TeeVau/nfc-garage-position-sensor/docs/assets/github-social-preview.png

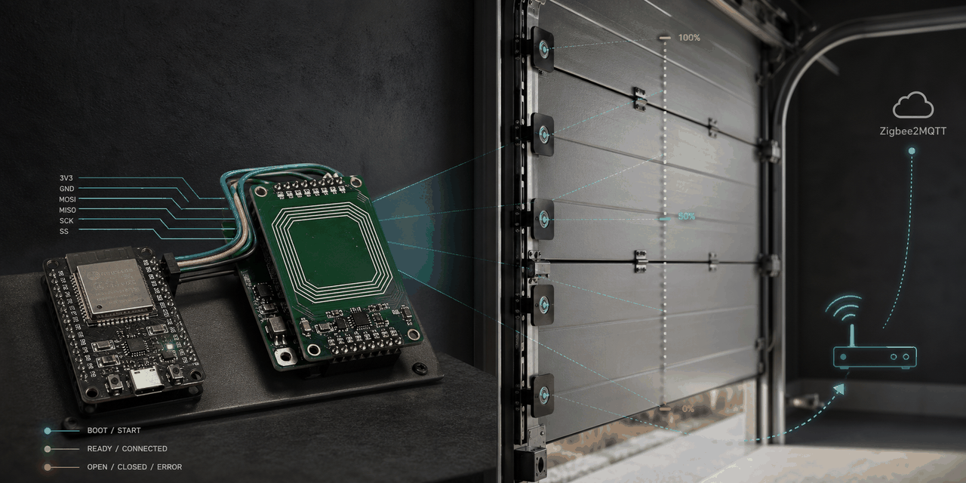
docs/assets/github-social-preview.png
