TeeVau/nfc-garage-position-sensor/docs/z2m-setup.md

# Zigbee2MQTT Setup For The Garage Door Sensor

This document describes the current simplified Zigbee2MQTT setup for the garage door sensor.

Repository layout note:

- firmware sources live under `src/nfc-garage-position-sensor`
- build and flash helpers live under `tools/firmware`

Goal:

- `position`: opening percentage with `0 = closed`, `100 = open`
- `state`: cover state as `CLOSE` / `OPEN`

The firmware currently exposes:

- endpoint `10`: window covering

Metadata relevant for Zigbee2MQTT:

- Basic `modelId`
- Basic `manufacturerName`
- Basic `powerSource`
- Basic `appVersion`
- Basic `swBuildId`

## External Converter In This Repository

If Zigbee2MQTT still classifies the device as unsupported or exposes incomplete metadata, use the repository-provided external converter:

- `zigbee2mqtt/external_converters/nfc-garage-position-sensor.js`

What this converter does:

- fingerprints the device by Basic `modelId = nfc-garage-position-sensor`
- fingerprints the device by Basic `manufacturerName = TeeVau`
- exposes read-only `position` and `state`
- binds reporting for `closuresWindowCovering` on endpoint `10`

Recommended installation:

1. Copy `zigbee2mqtt/external_converters/nfc-garage-position-sensor.js` into Zigbee2MQTT's `external_converters` directory next to its `configuration.yaml`.
2. Restart Zigbee2MQTT.
3. Remove the previously interviewed device if needed.
4. Pair the sensor again so Zigbee2MQTT interviews it with the external converter active.

Important note:

- The converter is intentionally read-only. The device is used as a position sensor even though it reports through the Window Covering cluster.

Important runtime note:

- The firmware actively reports position updates directly to coordinator endpoint `1`.
- Because of that, live `position` / `state` delivery no longer depends on Zigbee2MQTT having successfully stored endpoint `bindings` or `configured_reportings`.
- A manual `device/configure` can still improve metadata completeness, but it should no longer be required just to receive live position updates.

## Firmware-ID And Version Metadata

Zigbee2MQTT distinguishes between multiple version-related Basic-cluster attributes.

Important project detail:

- Espressif's documented Arduino Zigbee API exposes `setVersion()`, which writes Basic `appVersion`.
- In practice Zigbee2MQTT still reads Basic `swBuildId` separately for the UI field `Firmware-ID`.
- Our tests showed that `appVersion` alone is not enough: Zigbee2MQTT successfully read `appVersion`, but still reported `swBuildId` as `UNSUPPORTED_ATTRIBUTE`, which left `Firmware-ID` unresolved.

Because of that, the firmware intentionally contains a small local extension around `ZigbeeWindowCovering` that writes Basic attribute `0x4000` (`swBuildId`) before `Zigbee.begin()`.

This is deliberate and should not be removed as a "cleanup" unless Zigbee2MQTT is verified again against the real device.

Current mapping used by this project:

- `SOFTWARE_APPLICATION_VERSION` -> Basic `appVersion`
- `SOFTWARE_VERSION` -> serial startup banner and Basic `swBuildId`

## Pair Or Re-Pair The Device

Recommended path:

1. Build the current firmware with `.\tools\firmware\build.ps1`.
2. Flash it with `.\tools\firmware\flash.ps1` or, for a forced re-pair flow, `.\tools\firmware\flash-clean.ps1`.
3. Remove the already known garage sensor from Zigbee2MQTT.
4. Permit joining in Zigbee2MQTT.
5. Put the ESP32-C6 device into pairing mode again.
6. Let Zigbee2MQTT interview the device from scratch.

Why this is recommended:

- The firmware changed.
- A fresh interview is the most reliable way to make sure Zigbee2MQTT sees the current endpoint shape.

Local device hint during bring-up:

- even without the serial monitor, the onboard LED should show a short white boot flash followed by a visible blue startup/join indication
- after the device is ready, closed should appear green and non-closed should appear orange

## Expected Device Behavior In Zigbee2MQTT

Expected payload fields:

- `position`
- `state`

Expected semantics:

- `position: 0` means fully closed
- `position: 100` means fully open
- `state: "CLOSE"` means closed
- `state: "OPEN"` means open

For integrations and dashboards, use the unsuffixed fields:

- `position`
- `state`

If Zigbee2MQTT also shows endpoint-suffixed variants such as `position_10`, `position_default`, `state_10`, or `state_default`, treat those as secondary endpoint-specific or cached values. The intended stable consumer-facing fields for this project are the plain `position` and `state` keys.

## What You Should See During Tests

### Scan The 0% Tag

Expected meaning:

- door is closed
- opening percentage is `0`

Expected Zigbee2MQTT result:

```json
{
  "position": 0,
  "state": "CLOSE"
}
```

### Scan The 100% Tag

Expected meaning:

- door is fully open
- opening percentage is `100`

Expected Zigbee2MQTT result:

```json
{
  "position": 100,
  "state": "OPEN"
}
```

## Console vs Zigbee2MQTT

The firmware logs two related but different things:

- `TAG ...` lines: internal NFC-derived state
- `ZB ...` lines: values sent into Zigbee

Example:

```text
TAG 0 0 nfc
ZB open=0 lift=100 nfc
```

Interpretation:

- `open=0` is the project-level opening percentage
- `lift=100` is the Zigbee Window Covering cluster-facing value

The inverted `lift` value is expected internally for the window covering cluster implementation used here.

## Troubleshooting

### Position Looks Inverted

Check:

- the flashed firmware is current
- Zigbee2MQTT device option `invert_cover` is `false`

Expected:

- `0%` tag -> `position: 0`, `state: CLOSE`
- `100%` tag -> `position: 100`, `state: OPEN`

### Raw Debug Logging

To debug the real Zigbee traffic instead of only the summarized frontend log, temporarily enable debug logging in `configuration.yaml`:

```yaml
advanced:
  log_level: debug
```

If you also want debug logs visible in the Zigbee2MQTT frontend and MQTT stream, enable:

```yaml
advanced:
  log_level: debug
  log_debug_to_mqtt_frontend: true
```

After restart, move the door and look for raw messages involving:

- cluster `closuresWindowCovering`
- endpoint `10`

## FHEM Expectations

If FHEM consumes the Zigbee2MQTT MQTT payload, you should eventually see fields equivalent to:

- `ga_Torsensor_position = 0..100`
- `ga_Torsensor_state = OPEN | CLOSE`

The exact FHEM reading names depend on your MQTT mapping.

Example `MQTT2_DEVICE` setup for a Zigbee2MQTT friendly name `ga_Torsensor`:

```text
define ga_Torsensor MQTT2_DEVICE ga_Torsensor
attr ga_Torsensor DbLogInclude position
attr ga_Torsensor alias Garagentor Positionssensor
attr ga_Torsensor devStateIcon {\
  my $avail = ReadingsVal($name,'availability','online');; \
  my $icon;; \
  if($avail ne 'online') {\
    $icon = 'fts_garage@red';; \
  } else {\
    my $pos = ReadingsNum($name,'position',0);; \
    $pos = 0 if $pos < 0;; \
    $pos = 100 if $pos > 100;; \
    my $step = int(($pos + 5) / 10) * 10;; \
    my $iconStep = 100 - $step;; \
    $iconStep = 10 if $iconStep < 10;; \
    $iconStep = 100 if $iconStep > 100;; \
    $icon = 'fts_garage_door_' . $iconStep;; \
  }\
  return '<div style="display:flex;;align-items:center;;gap:6px;;">' .\
         FW_makeImage($icon) .\
         '<span>' . InternalVal($name,'STATE','') . '</span></div>';;\
}
attr ga_Torsensor devicetopic zigbee2mqtt/ga_Torsensor
attr ga_Torsensor icon fts_garage
attr ga_Torsensor readingList $DEVICETOPIC:.* { json2nameValue($EVENT) }\
$DEVICETOPIC/availability:.* { $EVENT =~ /"state"\s*:\s*"([^"]+)"/ ? {availability => $1} : {availability => $EVENT} }
attr ga_Torsensor room Garage
attr ga_Torsensor stateFormat state (position %)
```

Notes:

- The device is intentionally modeled as read-only in this project, so no `setList` is required.
- Live broker captures for this project show `zigbee2mqtt/ga_Torsensor` payloads like `{"last_seen":"...","linkquality":200,"position":22,"state":"OPEN"}`.
- `zigbee2mqtt/ga_Torsensor/availability` is a separate topic with `{"state":"online"}` and should not overwrite the main `state` reading.
- The tested FHEM variant keeps the standard Zigbee2MQTT reading name `linkquality` and does not use `jsonMap`.
- `devStateIcon` returns HTML so FHEM shows both the icon and the `stateFormat` text in one line.
- `devStateIcon` maps `position` to the `fts_garage_door_xx` icon series. Because the icon set uses `10 = open` and `100 = closed`, the mapping is intentionally inverted relative to the reported `position`.
- If your Zigbee2MQTT base topic or friendly name differs, replace the `devicetopic` value accordingly.

Minimal local attrTemplate snippet for your own FHEM template file:

```text
name:nfc_garage_position_sensor_z2m
filter:TYPE=MQTT2_DEVICE
desc:NFC garage position sensor via Zigbee2MQTT with position/state JSON payload
par:DEVICETOPIC;Full Zigbee2MQTT topic of the device;zigbee2mqtt/ga_Torsensor
attr DEVICE DbLogInclude position
attr DEVICE alias Garagentor Positionssensor
attr DEVICE devStateIcon {\
  my $avail = ReadingsVal($name,'availability','online');; \
  my $icon;; \
  if($avail ne 'online') {\
    $icon = 'fts_garage@red';; \
  } else {\
    my $pos = ReadingsNum($name,'position',0);; \
    $pos = 0 if $pos < 0;; \
    $pos = 100 if $pos > 100;; \
    my $step = int(($pos + 5) / 10) * 10;; \
    my $iconStep = 100 - $step;; \
    $iconStep = 10 if $iconStep < 10;; \
    $iconStep = 100 if $iconStep > 100;; \
    $icon = 'fts_garage_door_' . $iconStep;; \
  }\
  return '<div style="display:flex;;align-items:center;;gap:6px;;">' .\
         FW_makeImage($icon) .\
         '<span>' . InternalVal($name,'STATE','') . '</span></div>';;\
}
attr DEVICE devicetopic DEVICETOPIC
attr DEVICE icon fts_garage
attr DEVICE readingList $DEVICETOPIC:.* { json2nameValue($EVENT) }\
$DEVICETOPIC/availability:.* { $EVENT =~ /"state"\s*:\s*"([^"]+)"/ ? {availability => $1} : {availability => $EVENT} }
attr DEVICE room Garage
attr DEVICE stateFormat state (position %)
attr DEVICE model zigbee2mqtt_nfc_garage_position_sensor
setreading DEVICE attrTemplateVersion 20260430
```
