TeeVau/nfc-garage-position-sensor/(commit log)

2026-03-27 Initial ESP32 garage sensor sketch
2026-04-05 Finalize Zigbee sensor review state
2026-04-05 Modularize sketch into Arduino tabs
2026-04-05 Fix BLE debug connection stability
    [ble_debug.ino, nfc-garage-position-sensor.ino]
2026-04-05 Simplify Zigbee device to position-only sensor
2026-04-07 Fix Zigbee firmware metadata for z2m
    [config.h, nfc-garage-position-sensor.ino, zigbee.ino]
2026-04-09 Add Zigbee2MQTT external converter for garage sensor
2026-04-25 fix: handle millisecond permit join timestamps
2026-04-25 feat: add onboard status LED feedback (#5)
    * feat: add onboard status LED feedback
    * fix: show startup LED before Zigbee init
    [config.h, nfc-garage-position-sensor.ino, nfc_logic.ino, status_led.ino, zigbee.ino]
2026-04-25 docs: expand LED and Zigbee setup documentation
2026-04-26 fix: harden zigbee reporting and add debug capture helpers
    [ble_debug.ino, button.ino, config.h, nfc-garage-position-sensor.ino, zigbee.ino]
2026-04-29 docs: improve github landing page and social preview
