TeeVau/nfc-garage-position-sensor/(notices)

Notices in the files:
README.md:
License: GPLv3
